franzenhof/universal-weather-node/3dprint/rev13/preview.png

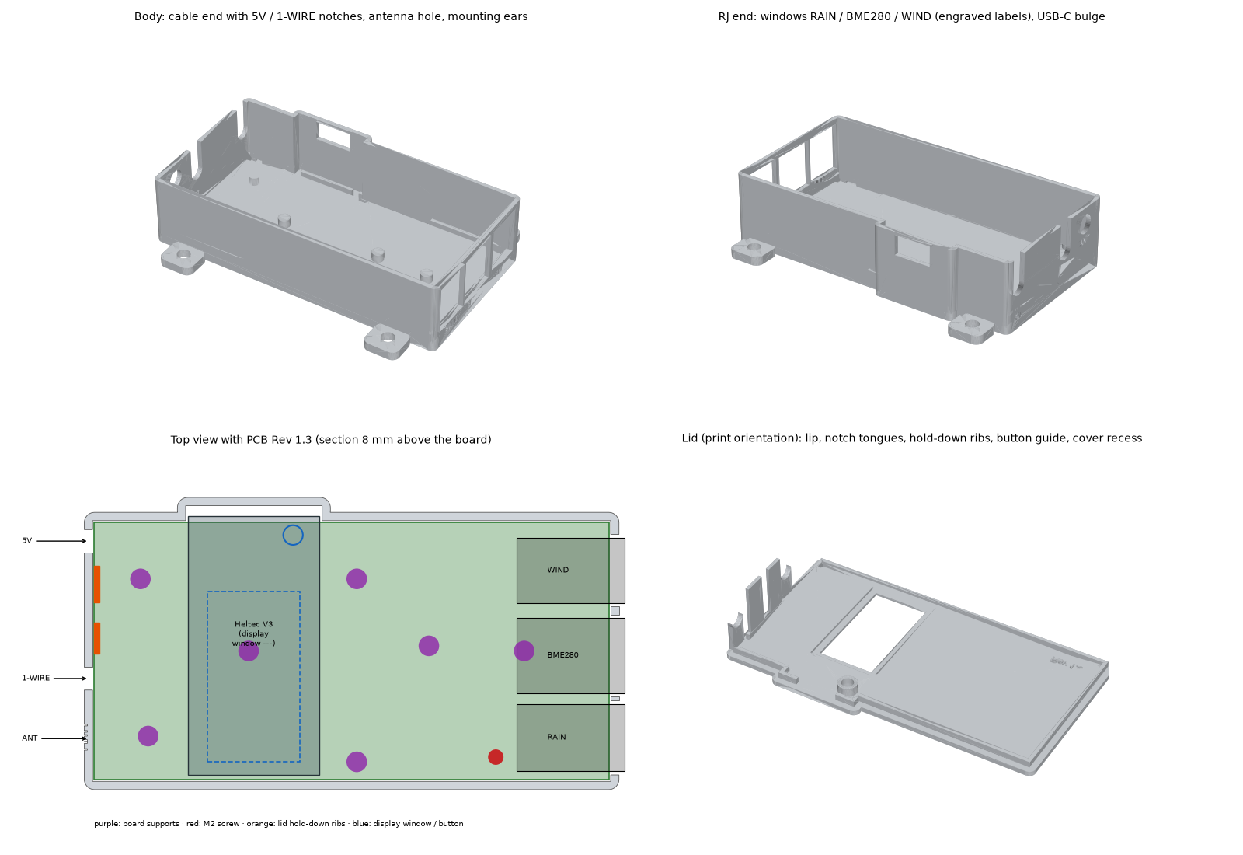
3dprint/rev13/preview.png
