franzenhof/universal-weather-node/3dprint/rev13/heltec weather node pcb v1.3 assembly.step

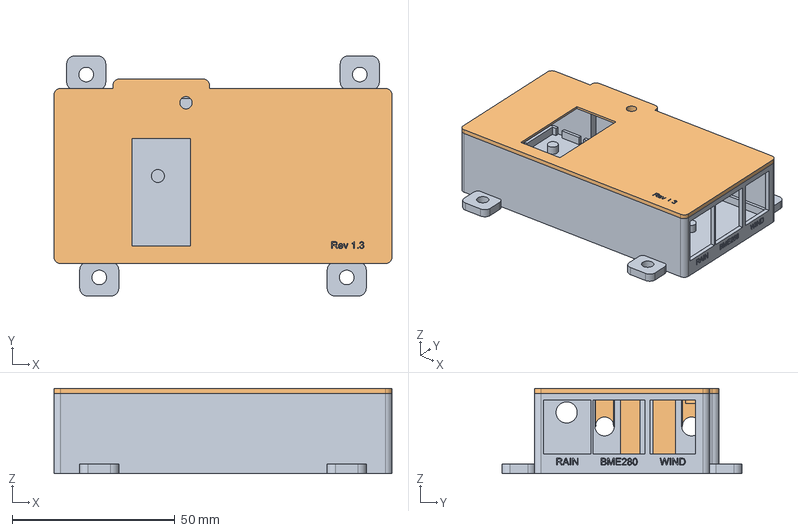
[picture p8: CAD file, 2026-10-25]
3dprint/rev13/heltec weather node pcb v1.3 assembly.step
103.8 x 73.8 x 26.2 mm
