franzenhof/universal-weather-node/3dprint/heltec weather node v2 button.stl

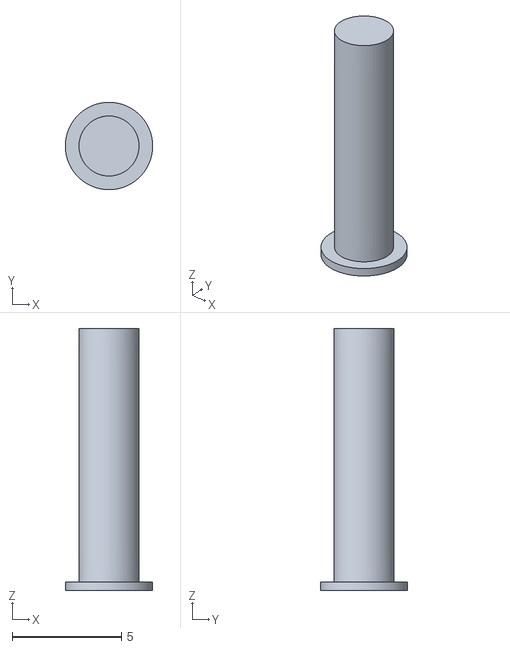
[picture p9: CAD file, 2026-08-09]
3dprint/heltec weather node v2 button.stl
4.00 x 4.00 x 12.0
