franzenhof/universal-weather-node/3dprint/rev13/heltec weather node pcb v1.3 case-body.step

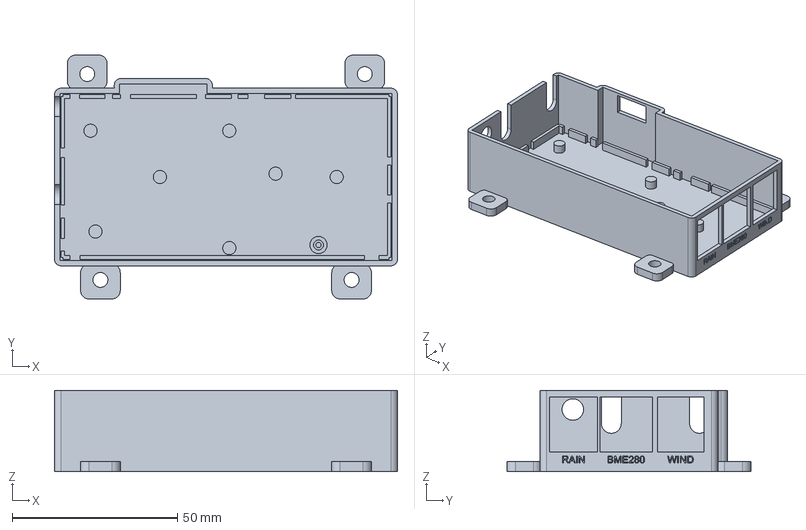
[picture p10: CAD file, 2026-10-25]
3dprint/rev13/heltec weather node pcb v1.3 case-body.step
103.8 x 73.8 x 24.6 mm
