franzenhof/universal-weather-node/3dprint/rev13/heltec weather node pcb v1.3 case-lid.step

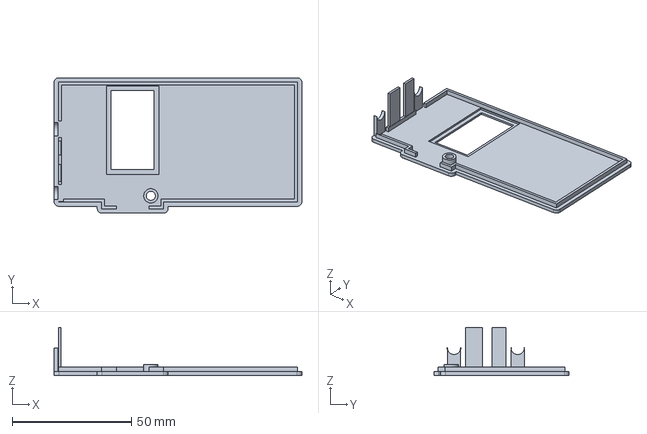
[picture p11: CAD file, 2026-10-25]
3dprint/rev13/heltec weather node pcb v1.3 case-lid.step
103.8 x 56.7 x 20.1 mm
