franzenhof/universal-weather-node/3dprint/rev13/heltec weather node pcb v1.3 button-pin.step

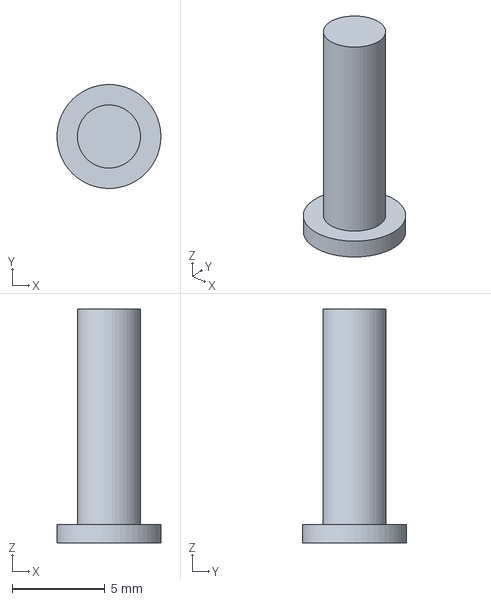
[picture p12: CAD file, 2026-10-25]
3dprint/rev13/heltec weather node pcb v1.3 button-pin.step
5.59 x 5.60 x 12.6 mm
