franzenhof/universal-weather-node/3dprint/rev12/heltec weather node pcb v1.2 Case-body.stl

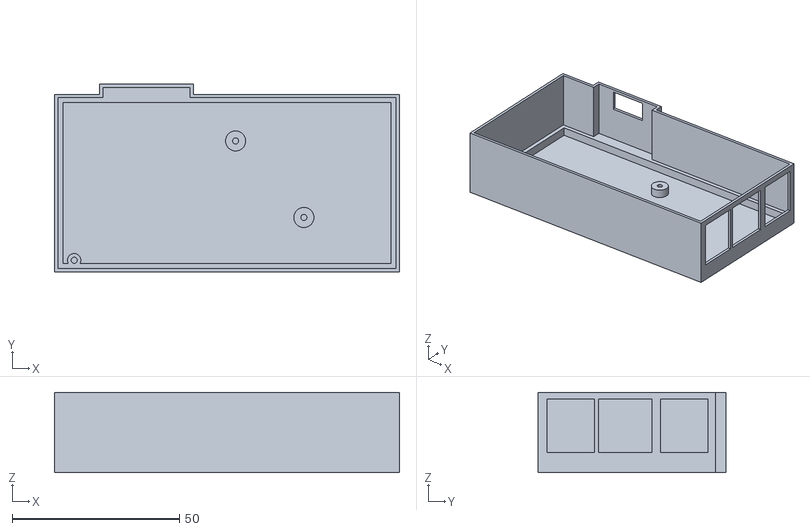
[picture p13: CAD file, 2026-10-25, an earlier design]
3dprint/rev12/heltec weather node pcb v1.2 Case-body.stl
103.0 x 56.0 x 24.0
