franzenhof/universal-weather-node/3dprint/rev12/heltec weather node v2 Case-top.stl

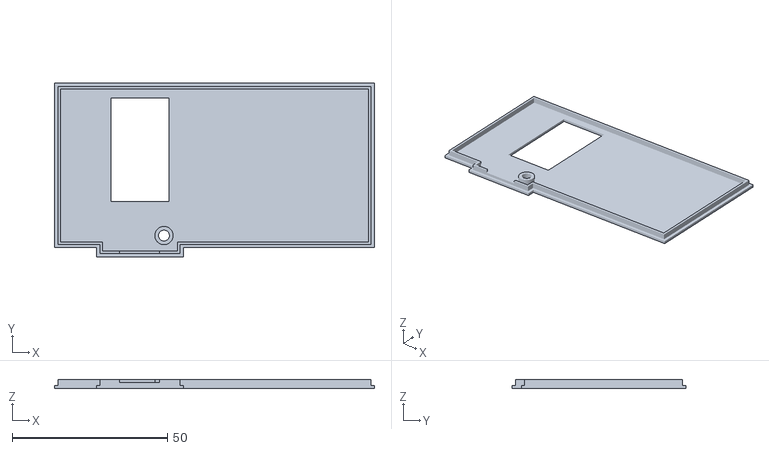
[picture p14: CAD file, 2026-10-25, an earlier design]
3dprint/rev12/heltec weather node v2 Case-top.stl
103.0 x 56.0 x 3.00
