franzenhof/universal-weather-node/(list of files, cad)

Other CAD files:
3dprint/heltec weather node v2.f3d
3dprint/rev13/heltec weather node pcb v1.3 button-pin.stl
3dprint/rev13/heltec weather node pcb v1.3 case-body.stl
3dprint/rev13/heltec weather node pcb v1.3 case-lid.stl
