franzenhof/universal-weather-node/(list of files, drawings)

Other design files:
pcblayout/lorawan-weather-node-pcb.fzz
