franzenhof/universal-weather-node/(commit log)

2026-08-09 Add wind-speed validation, PCB Rev 1.3 hardware updates, and README overhaul
    Firmware:
    - Reject implausible wind-speed pulses (>78 m/s / 281 km/h, above the Davis
    anemometer's rated max) instead of letting reed-switch bounce/EMI distort
    the average and gust values
    - Clamp all CayenneLPP/binary analog-input fields to +-327.67 before encoding
    to prevent silent int16 wraparound (affects rain rate and long-uptime debug
    fields)
    - Flip PCNT edge polarity on wind speed/rain per PCB revision, to match the
    new inverting Schmitt-trigger stage on Rev 1.3+
    - Replace magic pcbVersion numbers (12/13) with named PCB_REV_1_2/1_3
    constants
    Hardware (PCB Rev 1.3):
    - Add RC low-pass filtering (330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
2026-08-09 - Move the dashboard from /chart to / (webroot); /status keeps the old plain status table, /chart now redirects to / - Two-tier RRDtool-style in-RAM history ring buffer (24h fine / 7-day coarse tier)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
2026-10-18 ## ⚠️ Breaking: payload changes
    Update `chirpstack/decoder.js` in ChirpStack together with this firmware. The new decoder still decodes payloads from older firmware, so it can safely be deployed first. Metric users are only affected by the debug channels.
    - Compact binary format bumped to version 2: in imperial mode rain is encoded x1000 (0.001 in) and pressure x100 (0.01 inHg). Previously a single 0.2 mm tip (0.008 in) was sent as 0 and pressure had ~3.4 hPa resolution. Rain since start is now uint32 (previously wrapped above 6553.5 mm). Metric values are unchanged.
    - CayenneLPP: imperial pressure is sent with 0.01 inHg resolution; debug channels Ch203 (free heap) and Ch204 (uptime, 0.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
2026-10-25 Frist case-version for 1.3 pcb
